nikhil-a123/tat/README.md

# tat
A compact ambient condition monitor

Parts 

USB
SWD
3 input buttons
