nikhil-a123/tat/hardware/schematic/tat_v1/MCU.kicad_sch

## KiCad design hardware/schematic/tat_v1/MCU.kicad_sch (2025-06-01)

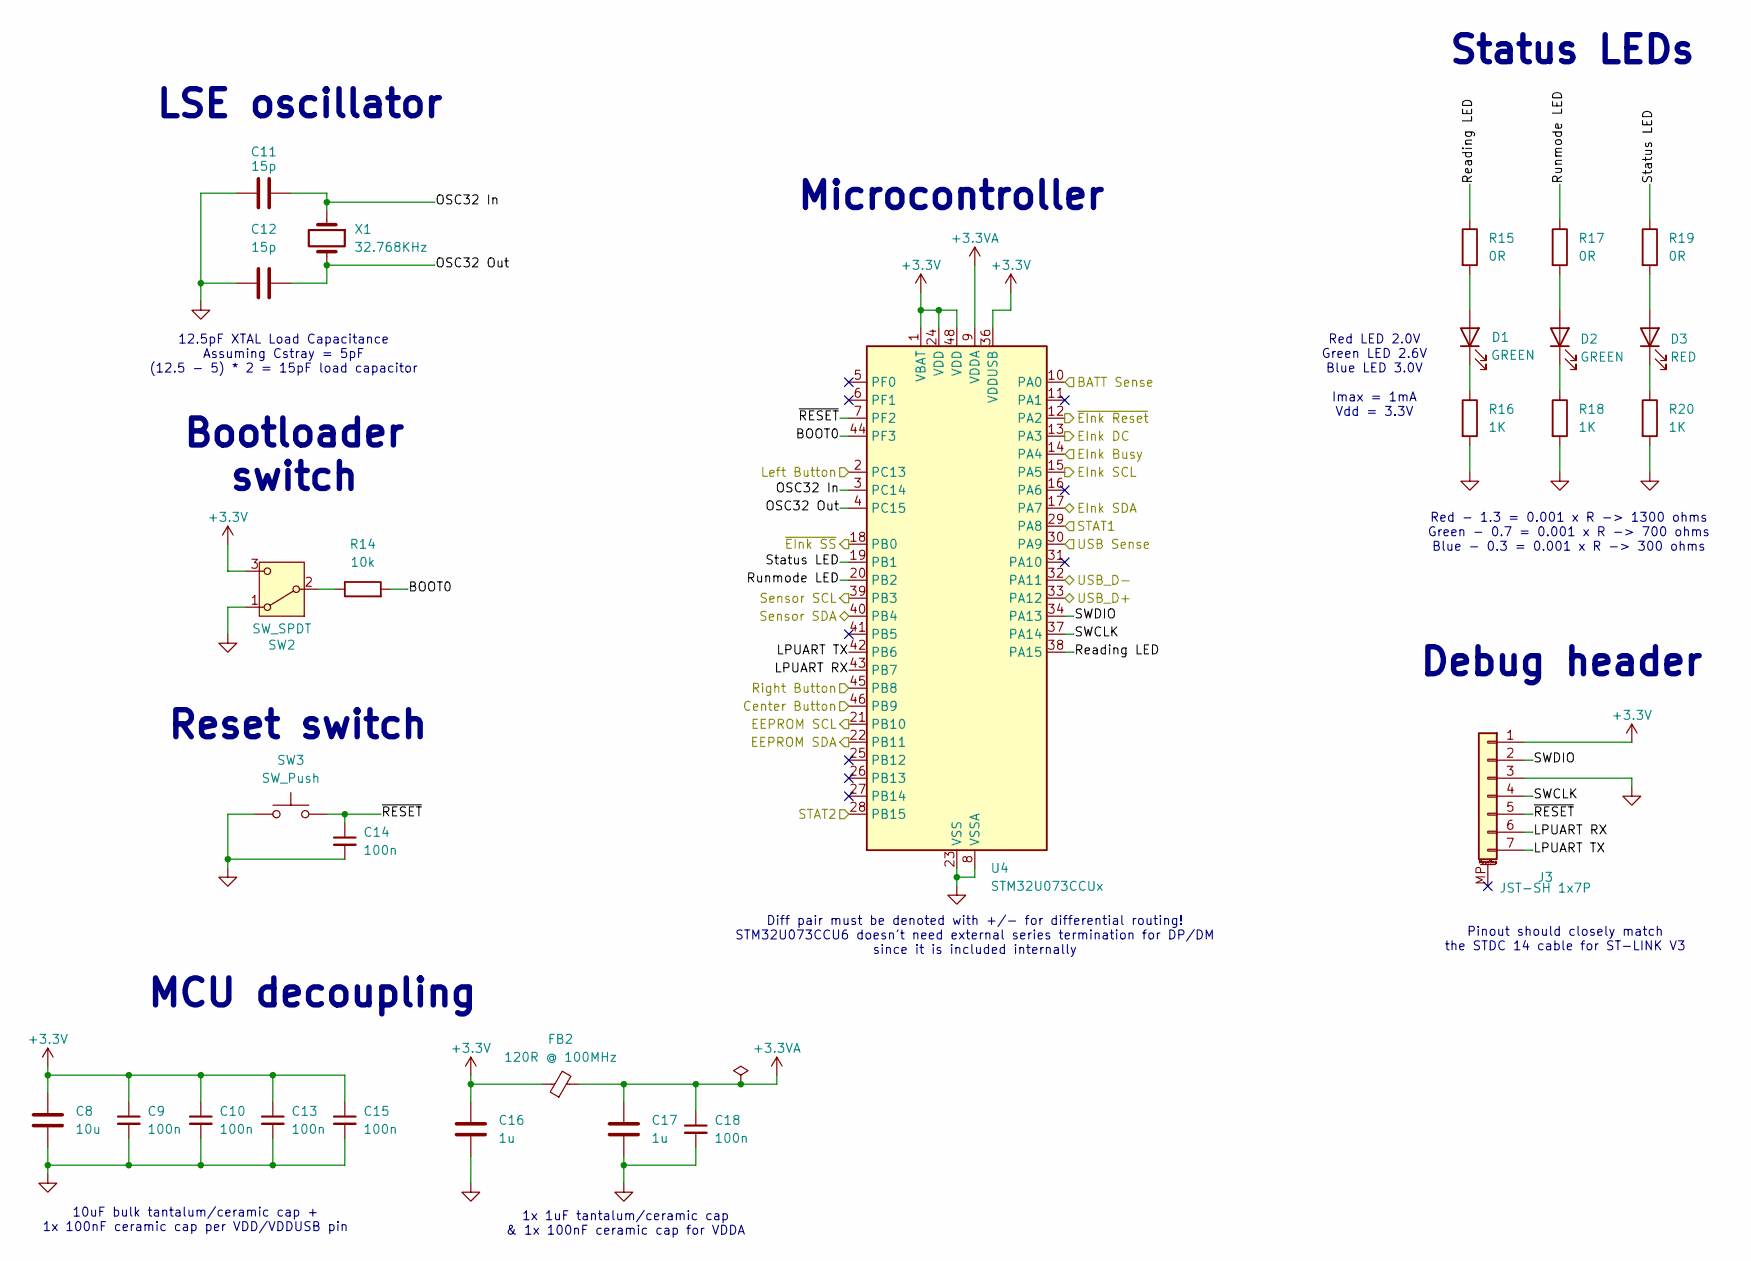
[picture p1: schematic MCU.kicad_sch]

Parts:
C8: 10u; C_0805_2012Metric
C9, C10, C13, C14, C15, C18: 100n; C_0402_1005Metric
C11, C12: 15p; C_0402_1005Metric
C16, C17: 1u; C_0603_1608Metric
D1, D2: GREEN; LED_0603_1608Metric
D3: RED; LED_0603_1608Metric
FB2: 120R @ 100MHz; L_0603_1608Metric
J3: JST-SH 1x7P; JST_SH_SM07B-SRSS-TB_1x07-1MP_P1.00mm_Horizontal
R14: 10k; R_0402_1005Metric
R15, R17, R19: 0R; SolderJumper-2_P1.3mm_Bridged2Bar_RoundedPad1.0x1.5mm
R16, R18, R20: 1K; R_0603_1608Metric
SW2: SW_SPDT; SW_SPDT_HANXIA_Mini_MSK12CO2
SW3: SW_Push; SW_Push_SHOU_HAN_SPST_RightAngle_TS24CA
U4: STM32U073CCUx; QFN-48-1EP_7x7mm_P0.5mm_EP5.6x5.6mm
X1: 32.768KHz; Crystal_SMD_3215-2Pin_3.2x1.5mm

Connections:
+3.3V: C8.1, C9.1, C10.1, C13.1, C15.1, C16.1, FB2.1, J3.1, SW2.3 (C), U4.1 (VBAT), U4.24 (VDD), U4.36 (VDDUSB), U4.48 (VDD)
+3.3VA: C17.1, C18.1, FB2.2, U4.9 (VDDA)
BATT Sense: U4.10 (PA0)
BOOT0: R14.2, U4.44 (PF3)
Center Button: U4.46 (PB9)
EEPROM SCL: U4.21 (PB10)
EEPROM SDA: U4.22 (PB11)
EInk Busy: U4.14 (PA4)
EInk DC: U4.13 (PA3)
EInk SCL: U4.15 (PA5)
EInk SDA: U4.17 (PA7)
GND: C8.2, C9.2, C10.2, C11.1, C12.1, C13.2, C14.2, C15.2, C16.2, C17.2, C18.2, J3.3, R16.2, R18.2, R20.2, SW2.1 (A), SW3.1, U4.8 (VSSA), U4.23 (VSS), U4.35 (VSS), U4.47 (VSS), U4.49 (VSS)
LPUART RX: J3.6, U4.43 (PB7)
LPUART TX: J3.7, U4.42 (PB6)
Left Button: U4.2 (PC13)
unnamed: D1.1 (K), R16.1
unnamed: D1.2 (A), R15.2
unnamed: D2.1 (K), R18.1
unnamed: D2.2 (A), R17.2
unnamed: D3.1 (K), R20.1
unnamed: D3.2 (A), R19.2
unnamed: R14.1, SW2.2 (B)
OSC32 In: C11.2, U4.3 (PC14), X1.1
OSC32 Out: C12.2, U4.4 (PC15), X1.2
Reading LED: R15.1, U4.38 (PA15)
Right Button: U4.45 (PB8)
Runmode LED: R17.1, U4.20 (PB2)
STAT1: U4.29 (PA8)
STAT2: U4.28 (PB15)
SWCLK: J3.4, U4.37 (PA14)
SWDIO: J3.2, U4.34 (PA13)
Sensor SCL: U4.39 (PB3)
Sensor SDA: U4.40 (PB4)
Status LED: R19.1, U4.19 (PB1)
USB Sense: U4.30 (PA9)
USB_D+: U4.33 (PA12)
USB_D-: U4.32 (PA11)
~EInk Reset: U4.12 (PA2)
~EInk SS: U4.18 (PB0)
~RESET: C14.1, J3.5, SW3.2, U4.7 (PF2)

Notes on the sheet:
LSE oscillator
Red - 1.3 = 0.001 x R -> 1300 ohms Green - 0.7 = 0.001 x R -> 700 ohms Blue - 0.3 = 0.001 x R -> 300 ohms
12.5pF XTAL Load Capacitance Assuming Cstray = 5pF (12.5 - 5) * 2 = 15pF load capacitor
1x 1uF tantalum/ceramic cap & 1x 100nF ceramic cap for VDDA
Reset switch
Diff pair must be denoted with +/- for differential routing! STM32U073CCU6 doesn't need external series termination for DP/DM since it is included internally
Microcontroller
Red LED 2.0V Green LED 2.6V Blue LED 3.0V Imax = 1mA Vdd = 3.3V
MCU decoupling
Debug header
Bootloader switch
Pinout should closely match the STDC 14 cable for ST-LINK V3
Status LEDs
10uF bulk tantalum/ceramic cap + 1x 100nF ceramic cap per VDD/VDDUSB pin
