nikhil-a123/tat/hardware/schematic/tat_v1/display.kicad_sch

## KiCad design hardware/schematic/tat_v1/display.kicad_sch (2025-06-01)

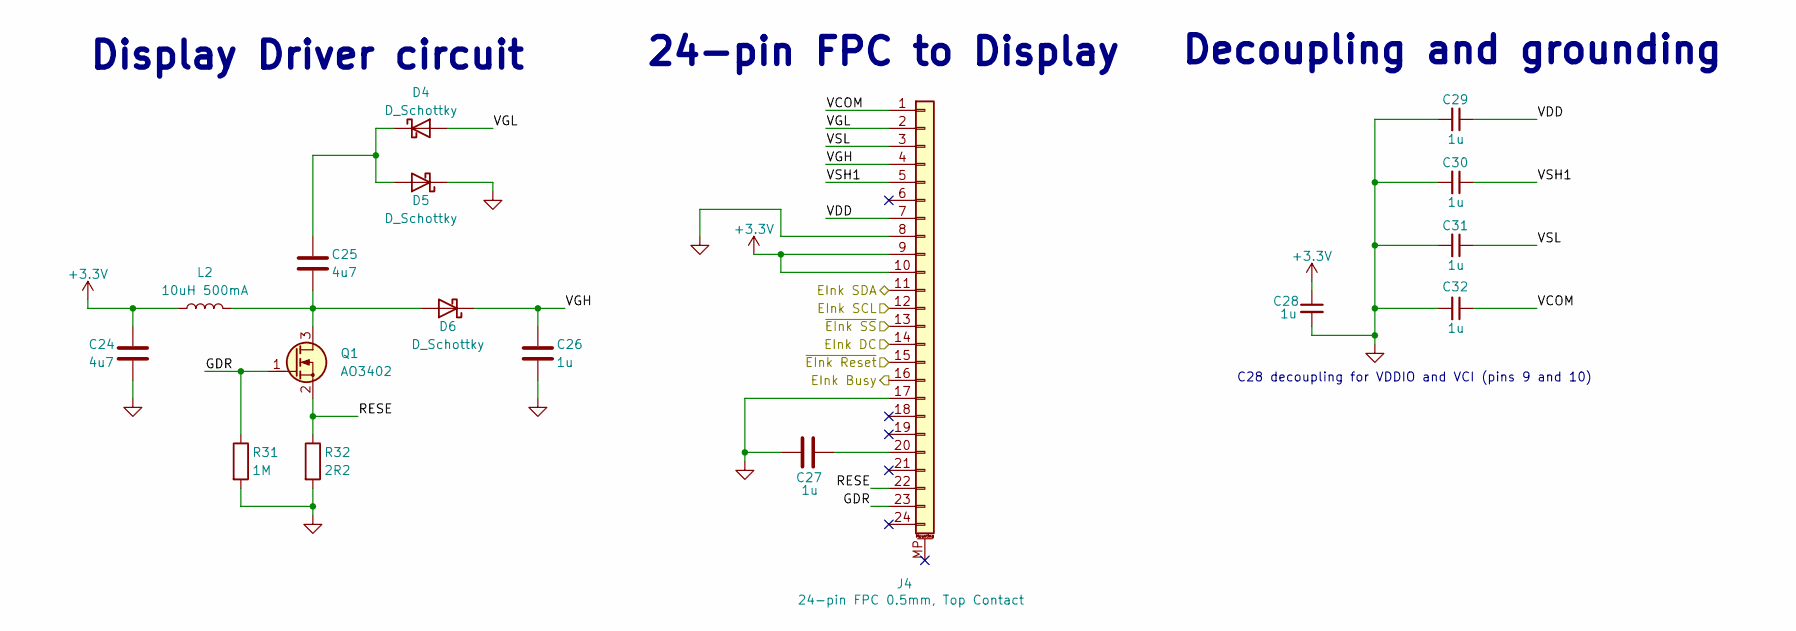
[picture p2: schematic display.kicad_sch]

Parts:
C24, C25: 4u7; C_0603_1608Metric
C26, C27, C28, C29, C30, C31, C32: 1u; C_0603_1608Metric
D4, D5, D6: D_Schottky; D_SOD-123
J4: 24-pin FPC 0.5mm, Top Contact; Jushuo_AFC07-S24FCA-00_1x24-1MP_P0.50_Horizontal
L2: 10uH 500mA; L_0805_2012Metric
Q1: AO3402; SOT-23
R31: 1M; R_0603_1608Metric
R32: 2R2; R_0603_1608Metric

Connections:
+3.3V: C24.1, C28.1, J4.9, J4.10, L2.1
EInk Busy: J4.16
EInk DC: J4.14
EInk SCL: J4.12
EInk SDA: J4.11
GDR: J4.23, Q1.1 (G), R31.1
GND: C24.2, C26.2, C27.2, C28.2, C29.2, C30.2, C31.2, C32.2, D5.1 (K), J4.8, J4.17, R31.2, R32.2
unnamed: C25.1, D4.1 (K), D5.2 (A)
unnamed: C25.2, D6.2 (A), L2.2, Q1.3 (D)
unnamed: C27.1, J4.20
RESE: J4.22, Q1.2 (S), R32.1
VCOM: C32.1, J4.1
VDD: C29.1, J4.7
VGH: C26.1, D6.1 (K), J4.4
VGL: D4.2 (A), J4.2
VSH1: C30.1, J4.5
VSL: C31.1, J4.3
~EInk Reset: J4.15
~EInk SS: J4.13

Notes on the sheet:
Display Driver circuit
24-pin FPC to Display
C28 decoupling for VDDIO and VCI (pins 9 and 10)
Decoupling and grounding
