nikhil-a123/tat/hardware/schematic/tat_v1/peripherals.kicad_sch

## KiCad design hardware/schematic/tat_v1/peripherals.kicad_sch (2025-06-01)

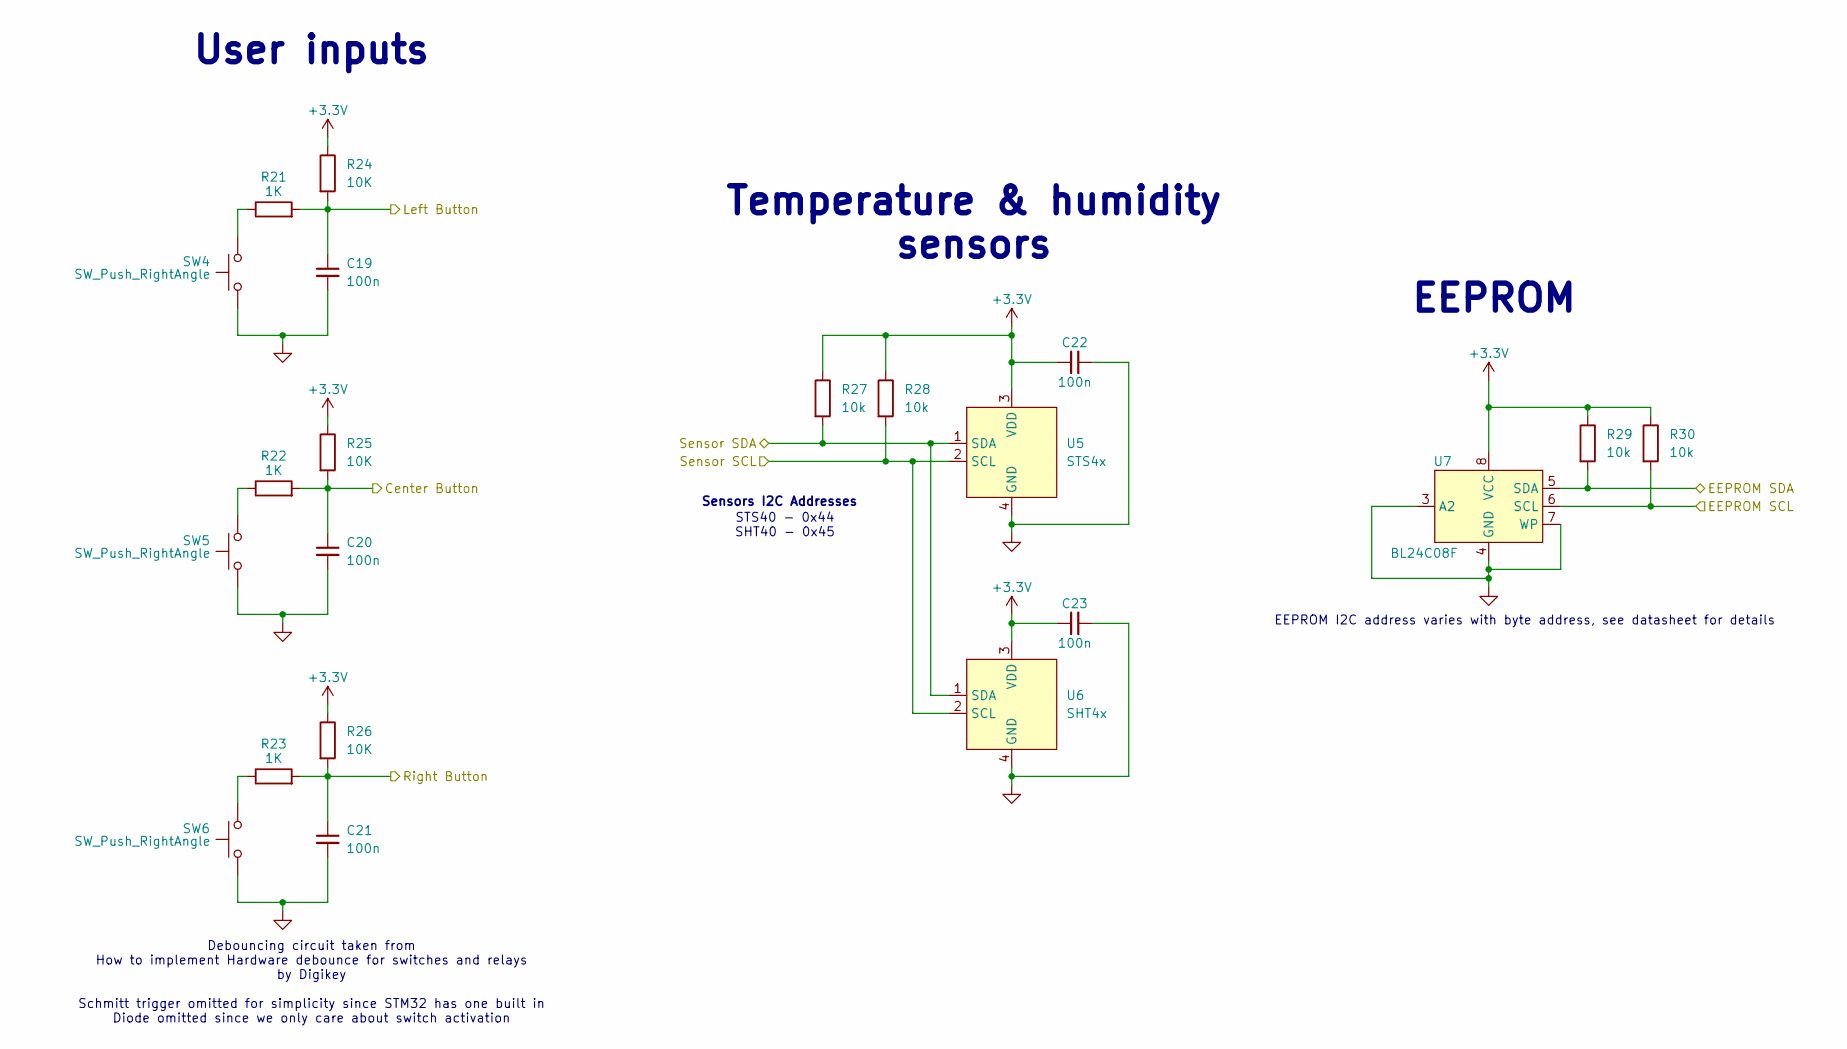
[picture p3: schematic peripherals.kicad_sch]

Parts:
C19, C20, C21, C22, C23: 100n; C_0402_1005Metric
R21, R22, R23: 1K; R_0402_1005Metric
R24, R25, R26: 10K; R_0402_1005Metric
R27, R28, R29, R30: 10k; R_0402_1005Metric
SW4, SW5, SW6: SW_Push_RightAngle; SW_Push_SHOU_HAN_SPST_RightAngle_TS24CA
U5: STS4x; Sensirion_DFN-4_1.5x1.5mm_P0.8mm_SHT4x_NoCentralPad
U6: SHT4x; Sensirion_DFN-4_1.5x1.5mm_P0.8mm_SHT4x_NoCentralPad
U7: BL24C08F; EEPROM_BL24C08F-NTRC

Connections:
+3.3V: C22.1, C23.1, R24.1, R25.1, R26.1, R27.1, R28.1, R29.1, R30.1, U5.3 (VDD), U6.3 (VDD), U7.8 (VCC)
Center Button: C20.1, R22.2, R25.2
EEPROM SCL: R30.2, U7.6 (SCL)
EEPROM SDA: R29.2, U7.5 (SDA)
GND: C19.2, C20.2, C21.2, C22.2, C23.2, SW4.1, SW5.1, SW6.1, U5.4 (GND), U6.4 (GND), U7.3 (A2), U7.4 (GND), U7.7 (WP)
Left Button: C19.1, R21.2, R24.2
unnamed: R21.1, SW4.2
unnamed: R22.1, SW5.2
unnamed: R23.1, SW6.2
Right Button: C21.1, R23.2, R26.2
Sensor SCL: R28.2, U5.2 (SCL), U6.2 (SCL)
Sensor SDA: R27.2, U5.1 (SDA), U6.1 (SDA)

Notes on the sheet:
Temperature & humidity sensors
EEPROM I2C address varies with byte address, see datasheet for details
User inputs
Debouncing circuit taken from How to implement Hardware debounce for switches and relays by Digikey Schmitt trigger omitted for simplicity since STM32 has one built in Diode omitted since we only care about switch activation
STS40 - 0x44 SHT40 - 0x45
EEPROM
Sensors I2C Addresses
