nikhil-a123/tat/hardware/schematic/tat_v1/untitled.kicad_sch

## KiCad design hardware/schematic/tat_v1/untitled.kicad_sch (2025-06-01)

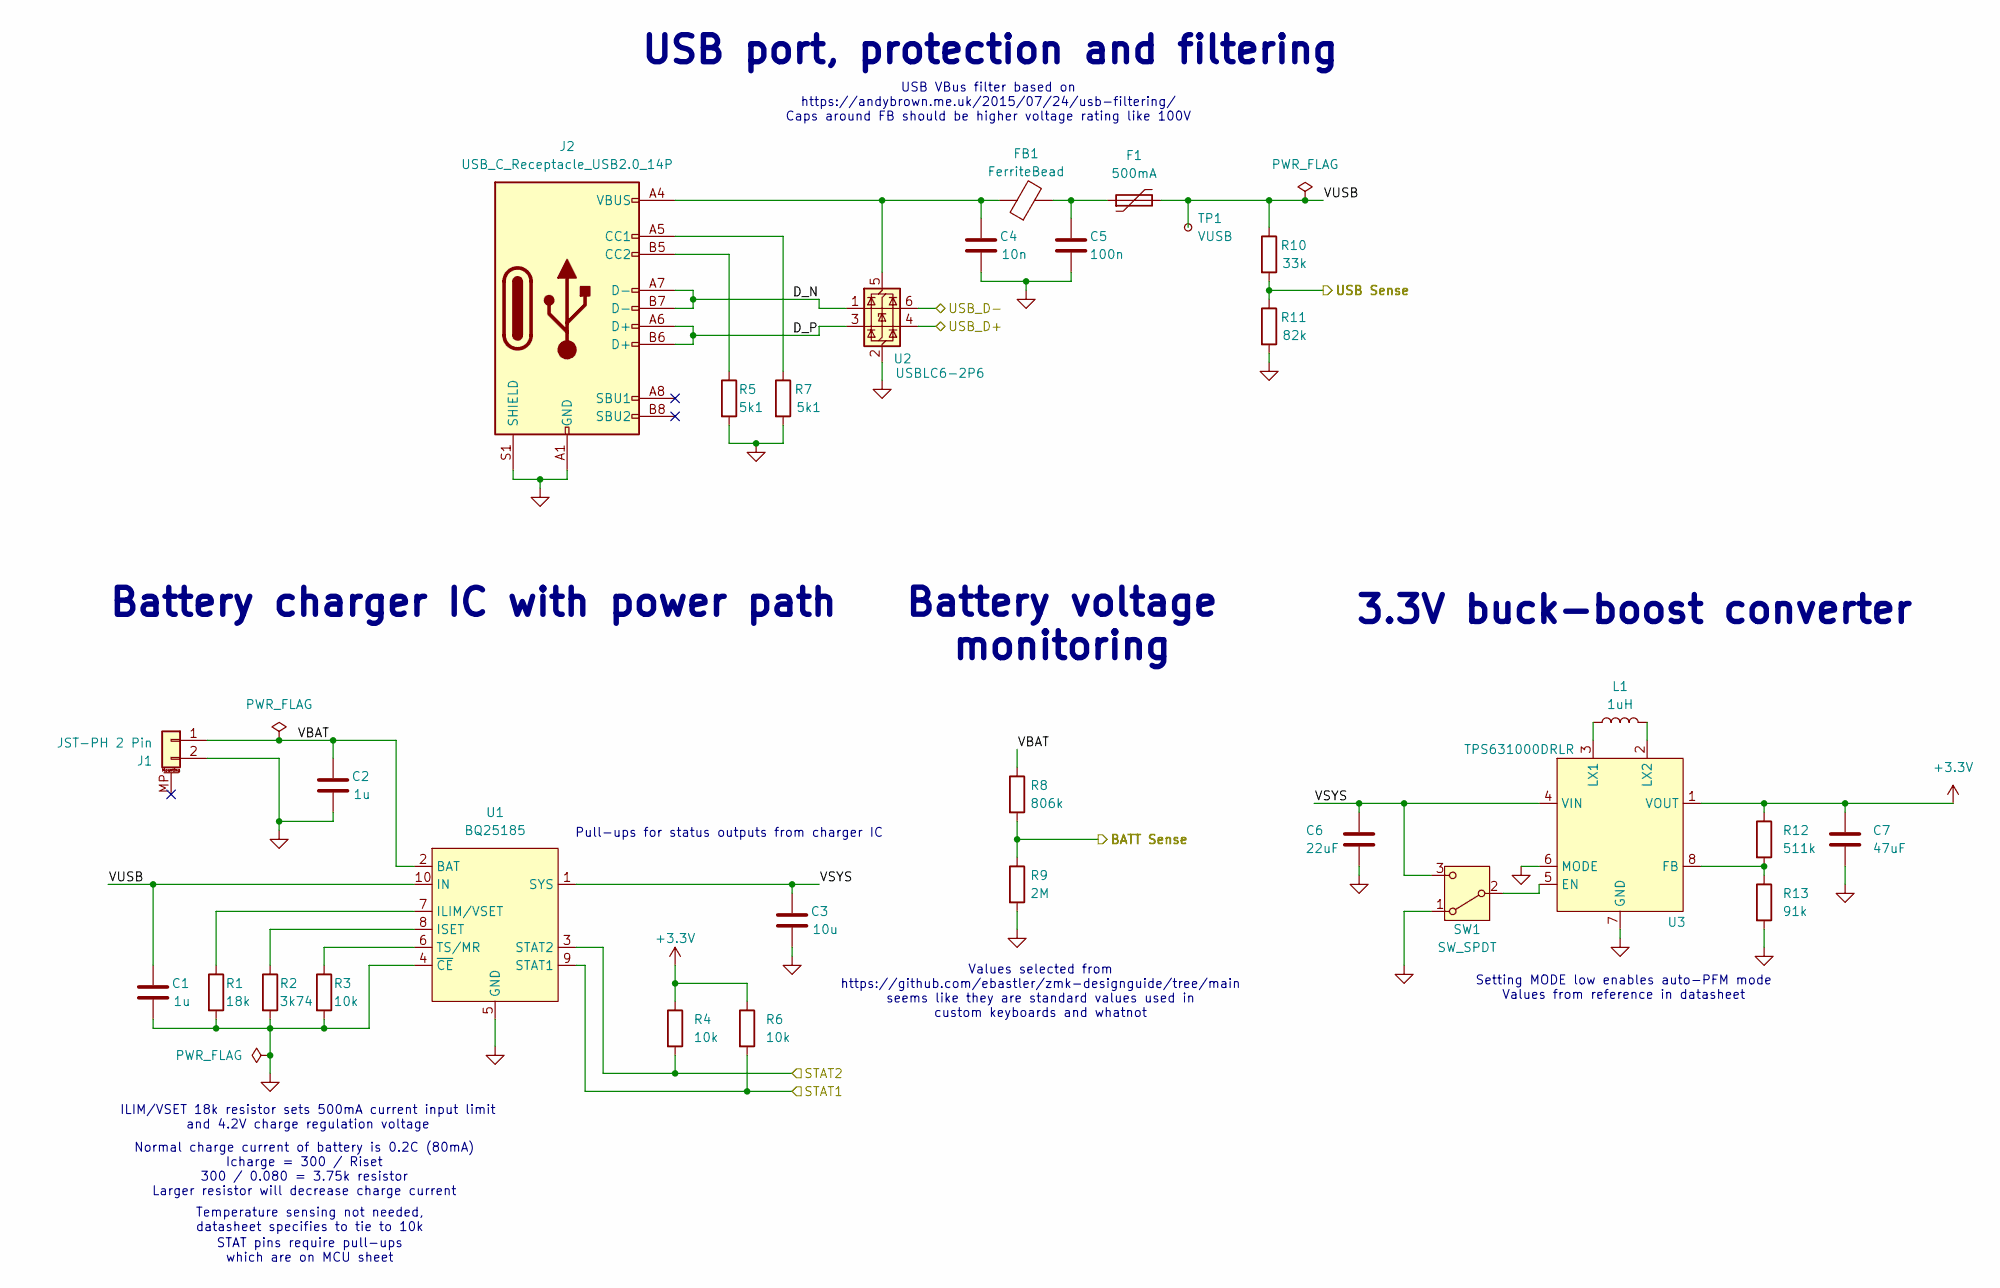
[picture p4: schematic untitled.kicad_sch]

Parts:
C1, C2: 1u; C_0603_1608Metric
C3: 10u; C_0805_2012Metric
C4: 10n; C_1206_3216Metric
C5: 100n; C_1206_3216Metric
C6: 22uF; C_0603_1608Metric
C7: 47uF; C_0603_1608Metric
F1: 500mA; Littelfuse_0805L_Polyfuse
FB1: FerriteBead; L_0603_1608Metric
J1: JST-PH 2 Pin; JST_PH_S2B-PH-SM4-TB_1x02-1MP_P2.00mm_Horizontal
J2: USB_C_Receptacle_USB2.0_14P; USB_C_Receptacle_HRO_TYPE-C-31-M-12
L1: 1uH; L_0603_1608Metric
R1: 18k; R_0402_1005Metric
R2: 3k74; R_0402_1005Metric
R3, R4, R6: 10k; R_0402_1005Metric
R5, R7: 5k1; R_0402_1005Metric
R8: 806k; R_0402_1005Metric
R9: 2M; R_0402_1005Metric
R10: 33k; R_0402_1005Metric
R11: 82k; R_0402_1005Metric
R12: 511k; R_0402_1005Metric
R13: 91k; R_0402_1005Metric
SW1: SW_SPDT; SW_SPDT_HANXIA_Mini_MSK12CO2
TP1: VUSB; TestPoint_Pad_D2.0mm
U1: BQ25185; WSON-10 BQ25185
U2: USBLC6-2P6; SOT-666
U3: TPS631000DRLR; SOT-583-8

Connections:
+3.3V: C7.1, R4.1, R6.1, R12.1, U3.1 (VOUT)
BATT Sense: R8.2, R9.1
D_N: J2.A7 (D-), J2.B7 (D-), U2.1 (I/O1)
D_P: J2.A6 (D+), J2.B6 (D+), U2.3 (I/O2)
GND: C1.2, C2.2, C3.2, C4.2, C5.2, C6.2, C7.2, J1.2, J2.A1 (GND), J2.A12 (GND), J2.B1 (GND), J2.B12 (GND), J2.S1 (SHIELD), R1.2, R2.2, R3.2, R5.2, R7.2, R9.2, R11.2, R13.2, SW1.1 (A), U1.4 (~CE), U1.5 (GND), U2.2 (GND), U3.6 (MODE), U3.7 (GND)
unnamed: C4.1, FB1.1, J2.A4 (VBUS), J2.A9 (VBUS), J2.B4 (VBUS), J2.B9 (VBUS), U2.5 (VBUS)
unnamed: C5.1, F1.1, FB1.2
unnamed: J2.A5 (CC1), R7.1
unnamed: J2.B5 (CC2), R5.1
unnamed: L1.1, U3.3 (LX1)
unnamed: L1.2, U3.2 (LX2)
unnamed: R1.1, U1.7 (ILIM/VSET)
unnamed: R2.1, U1.8 (ISET)
unnamed: R3.1, U1.6 (TS/MR)
unnamed: R12.2, R13.1, U3.8 (FB)
unnamed: SW1.2 (B), U3.5 (EN)
STAT1: R6.2, U1.9 (STAT1)
STAT2: R4.2, U1.3 (STAT2)
USB Sense: R10.2, R11.1
USB_D+: U2.4 (I/O2)
USB_D-: U2.6 (I/O1)
VBAT: C2.1, J1.1, R8.1, U1.2 (BAT)
VSYS: C3.1, C6.1, SW1.3 (C), U1.1 (SYS), U3.4 (VIN)
VUSB: C1.1, F1.2, R10.1, TP1.1, U1.10 (IN)

Notes on the sheet:
ILIM/VSET 18k resistor sets 500mA current input limit and 4.2V charge regulation voltage
Battery voltage monitoring
Normal charge current of battery is 0.2C (80mA) Icharge = 300 / Riset 300 / 0.080 = 3.75k resistor Larger resistor will decrease charge current
STAT pins require pull-ups which are on MCU sheet
3.3V buck-boost converter
USB VBus filter based on https://andybrown.me.uk/2015/07/24/usb-filtering/ Caps around FB should be higher voltage rating like 100V
Temperature sensing not needed, datasheet specifies to tie to 10k
Pull-ups for status outputs from charger IC
Values selected from https://github.com/ebastler/zmk-designguide/tree/main seems like they are standard values used in custom keyboards and whatnot
USB port, protection and filtering
Battery charger IC with power path
Setting MODE low enables auto-PFM mode Values from reference in datasheet
