nikhil-a123/tat/(commit log)

2025-01-23 Added stuff for prototype v0.1
    [tat_v0.1.kicad_pcb, tat_v0.1.kicad_sch]
2025-02-01 Added new application notes and data sheets. Added more details on prototype
2025-03-27 Moving to STM32U0, added datasheets
    [tat_v0.1.kicad_pcb, tat_v0.1.kicad_sch]
2025-04-01 Added HDC3022 sensor to partslist
2025-04-01 Moving away from SHT40 sensor
2025-04-01 Using different version of temperature sensor
2025-04-01 Added potential header for board-to-board connection
2025-04-01 Added potential part number for pin header for PCB
2025-04-02 Added Zetta EEPROM, and generated framework for KiCAD
    [tat_v1.kicad_pcb, tat_v1.kicad_sch]
2025-04-05 Started work on schematic. Laid out basic MCU power & gnd, and BOOT0 + NRST
    [tat_v1.kicad_sch]
2025-04-11 Added addressable RGB LED, right angle switch. Reorganised parts list
2025-04-22 Working on KiCAD schematic
    [tat_v1.kicad_sch]
2025-04-23 Added ESD diode to partslist
2025-04-25 Decided on Buck-boost converter. Added components on parts list for Eink display driving components. Altered USB-C housing.
2025-04-27 Completed most schematic symbols
2025-05-19 Added NPM1300, needs completion
    [MCU.kicad_sch, peripherals.kicad_sch, tat_v1.kicad_sch, untitled.kicad_sch]
2025-05-20 Simplified partslist and working on updated schematic
    [MCU.kicad_sch, peripherals.kicad_sch, tat_v1.kicad_sch, untitled.kicad_sch]
2025-05-21 Added some parts, working on USB and power inputs
    [untitled.kicad_sch]
2025-05-21 Working on power schematic
    [untitled.kicad_sch]
2025-05-22 Added small details to power sheet. Added PXRD's ferrite to partslist for reference
    [untitled.kicad_sch]
2025-05-22 Completed basic implementation of USB and battery charger schematic. Need to finish buck-boost part
    [untitled.kicad_sch]
2025-05-24 Basic circuit is complete, needs double checking
    [MCU.kicad_sch, display.kicad_sch, tat_v1.kicad_sch, untitled.kicad_sch]
2025-05-26 Need to implement checking battery charge tracking
    [untitled.kicad_sch]
2025-05-26 Added measuring battery voltage using the ADC. Basic schematic is complete, needs checking and refinement
    [MCU.kicad_sch, tat_v1.kicad_sch, untitled.kicad_sch]
2025-05-27 Cleaned up basic schematic and double checked all components. Need to complete ERC.
    [MCU.kicad_sch, peripherals.kicad_sch, tat_v1.kicad_sch, untitled.kicad_sch]
2025-05-27 Added note on how to improve ADC readings
2025-05-27 Added new titles to sheets
    [MCU.kicad_sch, display.kicad_sch, peripherals.kicad_sch, tat_v1.kicad_sch, untitled.kicad_sch]
2025-05-27 Used auto reference designator on whole schematic
    [MCU.kicad_sch, display.kicad_sch, peripherals.kicad_sch, untitled.kicad_sch]
2025-05-27 Working on assigning footprints. Fixed buck-boost output capacitor using wrong value.
    [untitled.kicad_sch]
2025-05-27 Synced hierarchical pins to sheets, need to fix rest of ERC errors
    [MCU.kicad_sch, tat_v1.kicad_sch, untitled.kicad_sch]
2025-05-27 Fixed all ERC errors and warnings
    [MCU.kicad_sch, display.kicad_sch, untitled.kicad_sch]
2025-05-27 Continuing with setting basic footprints for parts
    [MCU.kicad_sch, display.kicad_sch, peripherals.kicad_sch, untitled.kicad_sch]
2025-05-27 Continuing work on setting parts footprints
    [MCU.kicad_sch, peripherals.kicad_sch, untitled.kicad_sch]
2025-05-27 Most simple footprints added. Need to create footprints for more complex parts.
    [MCU.kicad_sch, display.kicad_sch, peripherals.kicad_sch]
2025-05-28 Added cool low power display sources from Alibaba
2025-05-31 Finished all footprints, can now start laying out circuit
    [MCU.kicad_sch, display.kicad_sch, peripherals.kicad_sch, untitled.kicad_sch]
2025-06-01 Fixed all footprint-symbol mismatches, ready to start routing!
    [MCU.kicad_sch, display.kicad_sch, peripherals.kicad_sch, tat_v1.kicad_pcb, untitled.kicad_sch]
